kirubel-g/evan-elec/(commit log)

2024-02-03 Initially Set the Pumps to Be OFF and Wait for Feedback from Sensors
2024-02-06 Set the pumps to be OFF during initialization
